m-okada/CPU298/README.md

# CPU298
CPU298 tiny 8 bit CPU.

フル機能版は https://github.com/m-okada/CPU2908
