m-okada/CPU298/CPU298.ods

Sheet: History
A00 | ”2021/04/18” | Create
B00 | “2022/09/28”

Sheet: Architecture
CPU298 アーキテクチャ
８ビットCPU、リトルエンディアン
レジスタ構成
データレジスタ | A
フラグ | FR | → | S | Z | C | フラグを内部バスに出力するルートは無いので、レジスタとして使用不可
インデックスレジスタ | X
 | Y |  | YはCALLの時にスタックとして使う
プログラムカウンタ | PC
アドレス計算にALUを使うようにして、回路規模を縮小。
相対ジャンプはフラグを変えるので、JA,JBE大事
アドレッシングモード
A
XH
XL
YH
YL
[X]
[Y]
zeropage

Sheet: Instruction
298 | Instruction Set |  |  |  |  |  |  |  |  |  |  |  |  |  |  | 2023/05/01
 | +00 | +01 | +02 | +03 | +04 | +05 | +06 | +07 | +08 | +09 | +0A | +0B | +0C | +0D | +0E | +0F
00 | NOP | MOV A,imm8 | MOV A,[imm16] | MOV A,[imm8] | MOV A,[X] | MOV A,[Y] | MOV A,[X+imm8] | MOV A,[Y+imm8] | MOV A,{imm8} | MOV {imm8},A | MOV [imm16],A | MOV [imm8],A | MOV [X],A | MOV [Y],A | MOV [X+imm8],A | MOV [Y+1mm8],A | 00
10 | MOV X,imm16 | MOV Y,imm16 | MOV X,[imm16] | MOV X,[imm8] | MOV X,[Y] | MOV Y,[imm16] | MOV Y,[imm8] | MOV Y,[X] | MOV A,{X+imm8} | MOV {X+imm8},A | MOV [imm16],imm16 | MOV [imm8],imm16 | MOV [X],imm16 | MOV [Y],imm16 | MOV [X+imm8],imm16 | MOV [Y+1mm8],imm16 | 10
20 | XCHG A,XL | XCHG A,XH | XCHG A,YL | XCHG A,YH | INC Y | ADD Y,2 | ADD Y,imm8 | MOV X,[Y+imm8] | XCHG XL,XH | XCHG YL,YH | XCHG X,Y | XCHG[imm8],A | DEC Y | SUB Y,2 | SUB Y,imm8 | MOV [Y+imm8],X | 20
30 | LEA |  |  |  | MOV X,[A] | MOV [A],X |  |  | MOV [X+],[Y+] | MOV [Y+],[X+] | MOV [X-],[Y-] | MOV [Y-],[X-] |  |  |  |  | 30
40 | PUSH [imm8] | PUSH [1mm16] | PUSH imm8 | PUSH imm16 | PUSH A | PUSH X | PUSH [A] | PUSH [X+A] | POP [imm8] | POP [imm16] |  |  | POP A | POP X | POP [A] | POP [X+A] | 40
50 |  |  |  |  |  |  |  |  | CLR A | CLR X | CLR Y | CLR [imm8] |  |  |  |  | 50
60 |  |  |  |  |  |  |  |  |  |  |  |  |  |  |  |  | 60
70 | SXT | NEG |  |  |  |  |  |  | SCR |  |  |  |  |  |  |  | 70
80 | ADD A,A | ADD A,imm8 | ADD A,[imm16] | ADD [imm8] | ADD A,[X] | ADD A,[Y] | ADD A,[X+imm8] | ADD A,[Y+1mm8] | SUB | A,imm8 | A,[imm16] | A,[imm8] | A,[X] | A,[Y] | A,[X+imm8] | A,[Y+imm8] | 80
90 | ADDC A,A | ADC A,imm8 | ADC A,[imm16] | ADC [imm8] | ADC A,[X] | ADC A,[Y] | ADC A,[X+imm8] | ADC A,[Y+1mm8] | SBB | A,imm8 | A,[imm16] | A,[imm8] | A,[X] | A,[Y] | A,[X+imm8] | A,[Y+imm8] | 90
A0 | AND | A,imm8 | A,[imm16] | A,[imm8] | A,[X] | A,[Y] | A,[X+imm8] | A,[Y+imm8] | CMP | A,imm8 | A,[imm16] | A,[imm8] | A,[X] | A,[Y] | A,[X+imm8] | A,[Y+imm8] | A0
B0 | XOR | A,imm8 | A,[imm16] | A,[imm8] | A,[X] | A,[Y] | A,[X+imm8] | A,[Y+imm8] | OR | A,imm8 | A,[imm16] | A,[imm8] | A,[X] | A,[Y] | A,[X+imm8] | A,[Y+imm8] | B0
C0 | NOT | X | [imm16] | [imm8] | [X] | [Y] | [X+imm8] | [Y+imm8] | TEST |  |  |  |  |  |  |  | C0
D0 | INC A | INC X | INC [imm16] | INC [imm8] | INC [X] | INC [Y] | INC [X+imm8] | INC [Y+imm8] | DEC A | X | [imm16] | [imm8] | [X] | [Y] | [X+imm8] | [Y+imm8] | D0
E0 | JNC(JAE) i8 | JC(JB) i8 | JNZ i8 | JZ i8 | JA i8 | JBE i8 | JNS i8 | JS i8 |  |  |  |  |  |  | JMPS i8 | JMPN imm8 | E0
F0 | BRK | TRAP |  |  |  | STC | CMC |  | CALL imm16 | CALL [imm8] |  | RET |  | JMP [X+A*2] | JMP imm16 | JMP [X] | F0
 |  | 動作未定義または実装未定
 |  | まだ実装してない |  | 黄色無印
 |  | 次ここ実装 |  | マゼンタ10
 |  | 回路動作確認町 |  | シアン10
 |  | 確認炭
 | Jcc i8はCP相対アドレス、8ビットイミディエート値オフセットは符号無し加算。
 | {}の指す16bit値でアドレッシングする
 | [imm8],[A] ゼロページ
 | +imm8 符号付き8ビットオフセット
 | SWB:Swap Byte.
 | SXT:Sign Extend.
 | PUSH/POP、CALL/RETのスタックはY
 | BRK 中身はNOPだけど、クロックを手動に切り替える
 | index mode
 | XCHG [Y+imm8],A | XCHG [Y+imm8],X | A,XL A,XH XL,XH X,Y

Sheet: μCode
15 | 14 | 13 | 12 | 11 | 10 | 9 | 8 | 7 | 6 | 5 | 4 | 3 | 2 | 1 | 0
Write | Read | /Thru | DEC/INC | ALU-Opecode |  |  |  | WriteBack-Selector |  |  | WR-Selector |  | ALU-A | ALU-B
Read=Write=1 |  | END_MARK 命令を終了してフェッチサイクルへ戻る
ALU-A |  | ALU A への入力、AかW
ALU-B |  | ALU B への入力、データバス、W、WR_H、WR_Lから選択
WR-Selector |  | ワードレジスタ出力選択
WriteBack-Selector |  | レジスタライトバック選択
DEC/INC |  | 1:DEC/0:INC
/Thru |  | 0:Thru Thru=0.DEC/INC=1 => add imm8(signed)
Write
Read
ALU Opecode |  | ALU-Opecode

Sheet: ALU_OP
CInv=A1&!A0&M#A2&!A1&A0&M ;
D3=!A1&!A0&M#!A2&A0&!M#A1&A0&M#A2&!A1&!M#A2&!A0&!M ;
D2=!A2&!A1&A0#!A1&A0&!M#!A2&A1&!M#A1&!A0&!M#A2&!A1&!A0&M ;
D1=!A2&A0#A0&M#A2&!A1&!A0&!M#A2&A1&M ;
D0=!A2&A1&!M#A2&!A1&A0&M#A2&A1&!A0&M ;
Mo=!A2&!A1#!A2&!A0&!M#!A1&!A0#A1&A0&M ;
Ci=A2&A1 ; | A1 & !A0 & M # A2 & A1
FL=!A1&!A0&!M#!A2&A1&A0&M#A2&!A1&!A0 ;
 |  | A3 | A2 | A1 | A0 | D3 | D2 | D1 | D0 | M | Ci | !FL | CInv
cupl truth table |  | A3 | A2 | A1 | A0 | D7 | D6 | D5 | D4 | D3 | D2 | D1 | D0
NOP |  | 0 | 0 | 0 | 0 | 0 | 0 | 0 | 0 | 1 | 0 | 1 | 0
AND |  | 0 | 0 | 0 | 1 | 1 | 0 | 0 | 0 | 1 | 0 | 0 | 0
OR |  | 0 | 0 | 1 | 0 | 1 | 1 | 1 | 0 | 1 | 0 | 0 | 0
XOR |  | 0 | 0 | 1 | 1 | 0 | 1 | 1 | 0 | 1 | 0 | 0 | 0
NOT |  | 0 | 1 | 0 | 0 | 0 | 1 | 0 | 1 | 1 | 0 | 0 | 0
INCA |  | 0 | 1 | 0 | 1 | 0 | 0 | 0 | 0 | 0 | 0 | 0 | 1 | Carryを立てて0を足すのでキャリーが反転するのに注意
DECA |  | 0 | 1 | 1 | 0 | 1 | 1 | 1 | 1 | 0 | 0 | 0 | 0
SignEx |  | 0 | 1 | 1 | 1 | 1 | 0 | 1 | 0 | 1 | 0 | 1 | 0
A-Thru |  | 1 | 0 | 0 | 0 | 1 | 0 | 1 | 0 | 1 | 0 | 1 | 0
B-Thru |  | 1 | 0 | 0 | 1 | 1 | 1 | 0 | 0 | 1 | 0 | 1 | 0
ADD |  | 1 | 0 | 1 | 0 | 1 | 1 | 0 | 0 | 0 | 0 | 0 | 0
SUB |  | 1 | 0 | 1 | 1 | 0 | 0 | 1 | 1 | 0 | 0 | 0 | 1
ADDC |  | 1 | 1 | 0 | 0 | 1 | 1 | 0 | 0 | 0 | 1 | 0 | 0
SUBB |  | 1 | 1 | 0 | 1 | 0 | 0 | 1 | 1 | 0 | 1 | 0 | 1
ADC0 |  | 1 | 1 | 1 | 0 | 0 | 0 | 0 | 0 | 0 | 1 | 0 | 0
SHR |  | 1 | 1 | 1 | 1 | 1 | 0 | 1 | 0 | 1 | 1 | 0 | 0
Cin 0の時0、1の時Carry
CInv(キャリー反転)はcarry入力、出力とも反転する
Carry出力はMが0の時Carry 1でExOpe&SHRの時に入力Bit0
M 0:Adder 1:LOP
A2..A0,M 4bitのOpe選択
 |  |  |  |  |  |  |  |  |  |  |  |  |  |  | addr
 |  |  |  |  |  |  |  |  |  |  |  |  |  |  | DEC/INC | ADD/THRU | Carry | Cout
 |  |  |  |  |  |  |  |  |  |  |  |  |  |  | 0 | 0 | 0 | 0 | Thru
 |  |  |  |  |  |  |  |  |  |  |  |  |  |  | 0 | 0 | 1 | X | X
 |  |  |  |  |  |  |  |  |  |  |  |  |  |  | 0 | 1 | 0 | 0 | INC
 |  |  |  |  |  |  |  |  |  |  |  |  |  |  | 0 | 1 | 1 | 1
 |  |  |  |  |  |  |  |  |  |  |  |  |  |  | 1 | 0 | 0 | 0 | ADD
 |  |  |  |  |  |  |  |  |  |  |  |  |  |  | 1 | 0 | 1 | 1
 |  |  |  |  |  |  |  |  |  |  |  |  |  |  | 1 | 1 | 0 | 1 | DEC
 |  |  |  |  |  |  |  |  |  |  |  |  |  |  | 1 | 1 | 1 | 0
 |  |  |  |  |  |  |  |  |  |  |  |  |  |  | DEC/INC | ADD/THRU | CarryIn
 |  |  |  |  |  |  |  |  |  |  |  |  |  |  | 0 | 0 | 0
 |  |  |  |  |  |  |  |  |  |  |  |  |  |  | 0 | 1 | 1
 |  |  |  |  |  |  |  |  |  |  |  |  |  |  | 1 | 0 | 0
 |  |  |  |  |  |  |  |  |  |  |  |  |  |  | 1 | 1 | 0

Sheet: PIN
 |  |  |  | CPU298 40PIN
 | I/O |  |  |  |  |  | I/O
クロック | I | CLK | 1 |  | 40 | Vcc | +5V | 電源
バス使用予告 | O | AVMA | 2 | CPU298 | 39 | Q | O
 |  |  | 3 |  | 38 | C | O
 |  |  | 4 |  | 37 | E | O
 |  |  | 5 |  | 36 | STATE | O | ステートアップデート
 |  |  | 6 |  | 35 | S1 | O | プロセッサステート | 0:フェッチ 1::実行
リセット | I | Reset | 7 |  | 34 | RD | O | 読み出し
アドレス | O | A0 | 8 |  | 33 | WR | O | 書き込み
 | O | A1 | 9 |  | 32 | D0 | I/O | データ
 | O | A2 | 10 |  | 31 | D1 | I/O
 | O | A3 | 11 |  | 30 | D2 | I/O
 | O | A4 | 12 |  | 29 | D3 | I/O
 | O | A5 | 13 |  | 28 | D4 | I/O
 | O | A6 | 14 |  | 27 | D5 | I/O
 | O | A7 | 15 |  | 26 | D6 | I/O
 | O | A8 | 16 |  | 25 | D7 | I/O
 | O | A9 | 17 |  | 24 | A15 | O | アドレス
 | O | A10 | 18 |  | 23 | A14 | O
 | O | A11 | 19 |  | 22 | A13 | O
電源 | GND | Vss | 20 |  | 21 | A12 | O

Sheet: TimingChart
 |  |  |  | ← |  | CPUサイクル |  | → | ← | CPUサイクル | → | →
 |  |  |  | 50ns＠20MHz
Reset | Clock |  | Q
 |  |  | C
 |  |  | E
fetch/execute | Clock |  | Q
 |  |  | C
 |  |  | E
Read cycle | ExternBusCtrl | Buffer | Addr/Data Latch |  | ←
 |  | Strobe | Read(OE)
Write cycle | ExternBusCtrl | Buffer | Addr/Data Latch |  | ←
 |  |  | Data Out Enable
 |  | Strobe | Write(WE)
Sequencer | Instruction |  | Instruction Register |  |  |  | ←
 | ControlCode
 |  |  | Fetch | ←
 |  | State | State-update |  |  | ←
 |  |  | ENDF | ←
 |  | uROM | uROM-addr-load |  | ←
 |  |  | uROM-addr-update |  |  | ←
Executer |  | Register | WriteBack |  |  |  | ←
 |  |  | WitebackDecoder OE |  |  |  | ←
 |  | Flag | Fetch |  |  |  |  | ←
Execute | Clock |  | Q
 |  |  | C
 |  |  | E

Sheet: Parts List
Block | Part no |  | 用途 | 備考
ExBus
 | 74HC74 | D-FFx2 | IRQA、DataOutコントロール
 | 74HC74 |  | RD、WRコントロール
 | 74HC08 | 2ANDx4
 | 74HC08
 | 74HC04 | INVx6
 | 74HC574 | D-FFx8 | Addr-Hi Latch
 | 74HC574 |  | Addr-Lo Latch
 | 74HC574 |  | DataOut Latch
 | 74HC125 | 3-State Buffer | Ctrl signal
Sequencer
 | 74HC74 |  | Stage Ctrl, Step Ctr.
 | 74HC74 |  | State Ctrl
 |  |  | Opecode Register
 | 74HC157 | 2to1x4 | JMPcc,OpeCodeSelector
 | 74HC157 |  | State Index Selector
 | 74HC157
 | 74HC08
 | 74HC08 |  |  | Jccに2回路
 | 74HC11 | 3ANDx3
 | 74HC32 | 2ORx4
 | 74HC04
 | 74HC21 | 4ANDx2 | INTイネーブル、Eライン | 1個余るのでStateCtrlとJccは一緒
 | 74HCT273 |  | μROM OUT
 | 74HCT273
 | 74HCT273
 | 74HCT273
 | 74HC541 |  | Datain imm8 selector
 | 74HCT574 |  | DataIn buffer
 | 74HC541 |  | DataIn thru
 | 74HC377 |  | μROM アドレスバッファ
 | 74HC161 |  | カウンタ
 | 74HC161
Jcc | 74HC161
 | 74HC11 | 3ANDx3
 | 74HC153 | 4to1x2 | Jcc フラグセレクタ | 1回路余り
 | 74HC04
 | 74HC86 | 2XORx4 |  | 一回路余り
 | 74HC32
Executer
 | 74HC574 |  | R0 | レジスタにLEDつけるのでピンの並びで574
 | 74HC574 |  | R1
 | 74HC574 |  | R2
 | 74HC574 |  | R3
 | 74HC377 |  | Buff1
 | 74HC377 |  | Buff2
 | 74HC574 |  | A0
 | 74HC574
 | 74HC574 |  | A1
 | 74HC574
 | 74HC574 |  | CP
 | 74HC574
 | 74HC574 |  | SP
 | 74HC574
 | 74HC238 |  | WriteBack
 | 74HC139 |  | BRSelector,BuffSel
 | 74HC541 | 3stateBuffer | BR out sel | ByteRegは別回路にするので、出力ディセーブル用
 | 74HC541 |  | DataIn
 | 74HC541 |  | BUSReturn
 | 74HC541 |  | AddrHI
 | 74HC541 |  | AddrLo
 | 74HC541 |  | addrLoOut
 | 74HC541 |  | addrHiOut
 | 74HC153 |  | WR out sel
 | 74HC153
 | 74HC153
 | 74HC153
 | 74HC153
 | 74HC153
 | 74HC153
 | 74HC153
Flag
 | 74HC377
 | 74HC157
 | 74HC157
CarrySelector
 | 74HC153
ALU
 | 74HC283 | 4bit adder
 | 74HC283
 | 74HC153 | Logic unit
 | 74HC153
 | 74HC153
 | 74HC153
 | 74HC153 | Out selector
 | 74HC153
 | 74HC153
 | 74HC153
 | 74HC86
 | 74HC153 |  | CarryOut
 | 74HC08
 | 74HC32
 | 74HC04
 | 74HC4078 | 8NOR | Zeroflag
AddrEx
 | 74HC08 | 2ANDx4 | Reg to 0
 | 74HC08
 | 74HC08
 | 74HC08
 | 74HC08 |  | selector
 | 74HC32 | 2ORx4
 | 74HC04 | NOTx6
 | 74HC157 | 2to1x4 | buff selector
 | 74HC157
 | 74HC157
 | 74HC157
 | 74HC283 |  | adder
 | 74HC283
 | 74HC283
 | 74HC283
 | Part no | 数 |  | 型番 | パッケージ | サプライヤー | ベンダー | PDF
 | 74HC04 | 5 |  | TC74VHCT04AFT | TSSOP14-P-0.65A | Toshiba | 秋月電子通商 | http://akizukidenshi.com/download/ds/toshiba/TC74VHCT04AFT.pdf
 | 74HC08 | 10 |  | 74HC08D,652 | SO14 | Nexperia | Digikey | https://assets.nexperia.com/documents/data-sheet/74HC_HCT08.pdf
 | 74HC11 | 2 |  | SN74HC11D | SO14 | TI | Digikey | http://www.ti.com/lit/ds/symlink/sn74hc11.pdf
 | 74HC138 | 0 |  | MC74HC138ADG | SOIC-16 | ON Semi | Digikey | https://www.onsemi.com/pub/Collateral/MC74HC138A-D.PDF
 | 74HC153 | 4 |  | 74HC153D,652 | SOIC-16-3.8mm | ON Semi | RSコンポーネンツ | https://docs-apac.rs-online.com/webdocs/1210/0900766b812104c5.pdf
 | 74HC157 | 9 |  | SN74HC157 | SOIC-16-3.8mm | TI | Digikey | http://www.ti.com/lit/ds/symlink/sn74hc157.pdf
 | 74HC21 | 1 |  | SN74HC21D | SOIC-14-3.8mm | TI | Digikey | http://www.ti.com/lit/ds/symlink/sn74hc21.pdf
 | 74HC238 | 1 | WriteBack active-hi | TC74HC238D | SOIC-16-1.27-3.8mm | Toshiba | Digikey | 74HC238D_datasheet_en_20160804.pdf
 | 74HC283 | 6 |  | CD74HC283M96 | SOIC-16-1.27-3.9mm | TI | Digikey | http://www.ti.com/lit/ds/symlink/cd74hc283.pdf
 | 74HC32 | 4 |  | 74AHC32D,118 | SOIC-14-3.9mm | Nexperia | Digikey | https://assets.nexperia.com/documents/data-sheet/74AHC_AHCT32.pdf
 | 74HC377 | 4 |  | SN74HC377NSR | SOIC-20-5.3 | Nexperia | chip1stop | http://www.ti.com/lit/ds/symlink/sn74hc377.pdf
 | 74HC4078 | 1 |  | TC74HC4078AF | SOP14-1.27-5.3m | Toshiba | chip1stop | https://www.marutsu.co.jp/contents/shop/marutsu/datasheet/TC74HC4078A.pdf
 | 74HC541 | 9 |  | TC74VHCT541AFT | TSSOP-20-0.65-4.4mm | Toshiba | 秋月電子通商 | http://akizukidenshi.com/download/ds/toshiba/TC74VHCT540_541AF.pdf
 | 74HC574 | 10 | LEDつけるのでSOIC | TC74VHC574F | SOP20-P-300-1.27A | Toshiba | 秋月電子通商 | TC74VHC574F_datasheet_ja_20190131.pdf
 | 74HC74 | 4 |  | MC74HC74ADG | SIOC-14-3.8mm | ON Semi | Digikey | https://www.onsemi.jp/PowerSolutions/document/MC74HC74A-D.PDF
 | 74HC86 | 2 |  | SN74AHC86D | SOIC-14-3.9mm | TI | Digikey | http://www.ti.com/lit/ds/symlink/sn74ahc86.pdf
 | 74HCT574 | 1 |  | SN74HCT574 | SOIC-20-5.3mm | TI | Digikey | http://www.ti.com/lit/ds/symlink/sn74hct574.pdf
 | 74HCT273 | 2 | μROMラッチ TTLを受けるのでHCT、あとリセット付き | 74HCT273D,653 | SO20-1.27.7.5mm | Nexperia | chip1stop | https://assets.nexperia.com/documents/data-sheet/74HC_HCT273.pdf
 | 74HC125 | 1 |  | TC74HC125 | SOP14-1.27-5.3mm | Toshiba | 手持ち | https://www.marutsu.co.jp/contents/shop/marutsu/datasheet/TC74HC125A.pdf
 | 74HCT125 | 0 |  | MC74ACT125 | SOIC-14 |  | 手持ち | https://www.onsemi.jp/PowerSolutions/document/MC74AC125-D.PDF
 | 74HC161 | 3 |  | TC74HC161AF | SOP-16-5.3mm | Toshiba | 秋月電子通商 | http://akizukidenshi.com/download/ds/toshiba/TC74HC161A.pdf
 | 74HC139 | 1 |  | MC74HC139ADR2G | SOIC-16-1.27-3.8mm | ON Semi | Digikey | https://www.onsemi.com/pub/Collateral/MC74HC139A-D.PDF
 | N61C64 | 0 | SRAM | N61C64AL-10JLI | SOJ-28 |  |  | http://www.issi.com/WW/pdf/61C64AL.pdf
 | 74HCT541 | 0
 | 74HC153 | 4
 |  | 0
 | 74ACT125 | 0 |  | MC74ACT125 | SIOC-14-3.8mm | ON Semi | 手持ち | https://www.onsemi.com/pub/Collateral/MC74AC125-D.PDF
 | TC7S32F | 0 |  | TC7S32F | SSOP-5 | Toshiba | 秋月電子通商 | http://akizukidenshi.com/download/ds/Toshiba/TC7S32F_datasheet_ja_20140301.pdf
 |  | 84
 | コントローラ
 | SRAM | 4 |  | IS61C64AL-10JLI-TR | 28-SOJ | ISSI | MOUSER | 8kx8 10ns
 | LED-Green
 | LED-White
 | 10K
 | 47K
 | 0.1uF

Sheet: PartsList2
パーツリスト
 |  |  | # | 概要 | Function | 型番 | ピン数 | 数 | 機能
Core | Extern Bus | Addr Buffer |  | HC574 |  | TC74HC574 | 20 | 2 | 100個ならDigiKeyが安い
 |  | Data Out Buffer |  | HC574 |  |  | 20 | 1
 |  | Data In Buffer |  | HCT541 |  |  | 20 | 1
 | clock |  |  | HC175 | 4xDFF |  | 16 | 1 | リセット時のメタステーブル対策
 |  |  |  | HC175 | 4xDFF |  | 16 | 1 | クロック生成
 |  |  |  | HC04 | NOT |  | 14 | 1 | 4回路余り
 | Bus ctrl |  |  | HC00 | 2NAND |  |  | 1
 |  |  |  | HC02 | 2NOR |  |  | 1
 |  |  |  | HC04 | NOT |  |  | 0 | clockからもらう
 | manual clock |  |  | HC00 | 2NAND |  | 14 | 1 | SRラッチ、チャタリング除去
Sequencer |  | μROM |  | 27C1024 | x16-μROM |  | 44 | 0 | PLCC-45NS OTP
 |  |  |  | AT28HC64B | 8Kx8-μROM |  | 32 | 1 | PLCC-70JU
 |  |  |  | HC574 | μROM-Lo Latch |  |  | 1
 |  |  |  | HC377 | Instruction Register |  | 20 | 1
 |  |  |  | HC377 | μROM addr Hi |  | 20 | 1
 |  |  |  | HC161 | μROM addr Lo |  | 16 | 1 | 4bit counter
 |  |  |  | HC74 | State control |  |  | 1 |  | 共立
 |  |  |  | HCT74 | Step bit0 |  | 14 | 1
 |  | CtrlCode |  | HCT273 |  |  | 20 | 2
 |  | Jcc |  | HC157 |  |  | 16 | 1
 |  | misc |  | HC11 | 3AND |  |  | 1 | 1回路はOpGenへ
 |  |  |  | HC08 | 2AND |  |  | 1
 |  |  |  | HC86 | 2XOR |  |  | 1 | 3回路あまり ALUへ
 |  |  |  | HC02 | 2NOR |  |  | 1 | 1回路あまり
 |  |  |  | HC153 | 4to1 Mutex |  | 16 | 1
 |  |  |  | HC157 | 2to1 Mutex |  | 16 | 2
 |  |  |  | HC04 | NOT |  |  | 2
Executer |  | Register |  | HC377,HC273 |  |  |  | 2 | A,W
 |  |  |  | HC574 |  |  |  | 8 | WORD Register
 |  | RegisterSelector |  | 74HC153 | 4to1x2 |  |  | 4 | ALU_A Selector | 樫木総業
 |  |  |  | HC541 |  |  |  | 0
 |  |  |  | HC157 | 2to1 |  |  | 2 | ALU_B Selector
 | Addr inc/dec | INC/DEC8 |  | GAL22 | 8bit INC/DEC |  | 24 | 1
 |  |  |  | GAL16 | Carry Gen |  | 20 | 1
 |  |  |  | HC283 | 4Adder |  | 16 | 2
 | ALU | OPGen |  | GAL16 |  |  | 20 | 1
 |  |  |  | HC21 | 4AND |  | 14 | 1
 |  |  |  | HC04 | NOT |  |  | 1
 |  | ALU_L |  | GAL16 | 4to1x4 |  |  | 2
 |  | ALU_A |  | HC283 |  |  |  | 2
 |  |  |  | HC541 | 3State8 |  |  | 1
 |  | Ext |  | GAL22 |  |  | 24 | 1
 |  | Flag |  | HC74 |  |  |  | 2
 |  |  |  |  |  |  |  | 60
SubBoard
