m-okada/CPU298/(list of files, drawings)

Other design files:
CPU298.circ
CPU298_parts_placement.circ
