m-okada/CPU298/(commit log)

2021-06-01 Add CPU298.ods
    [CPU298.circ, CPU298.ods]
2021-06-03 add makefile.
    [CPU298.circ, CPU298.ods, urom_A00.obj]
2021-06-04 Modify circ
    [CPU298.circ, CPU298.ods]
2021-06-04 Add ALU_OP_ROM*.*
    [CPU298.circ, CPU298.ods]
2021-06-05 Add INC_DEC_8.PLD
    [CPU298.circ]
2021-06-05 SignEx move into ALUblock.
    [CPU298.circ]
2021-06-06 Update uROM.
    [CPU298.circ, CPU298.ods, urom_A00.obj]
2021-06-09 ADD ALU_ROM.
    [CPU298.circ, CPU298.ods, urom_A00.obj]
2021-06-09 Update ROM
    [urom_A00.obj]
2021-06-09 remove exe,obj
    [urom_A00.obj]
2021-06-10 Update uROM
    [CPU298.circ]
2021-06-10 Update ALU_ROM
    [CPU298.circ]
2021-06-12 Move ALU_OP to 1 bit right.
    [CPU298.circ, CPU298.ods]
2021-06-13 Fix minor bug.
    [CPU298.circ]
2021-06-13 Support sign flag
    [CPU298.circ]
2021-06-13 Support JA JBE
    [CPU298.circ]
2021-06-13 Support ST [X],A
    [CPU298.circ, CPU298.ods]
2021-06-17 Create KiCAD project.
    [CPU298.circ, CPU298.kicad_pcb, CPU298.ods, CPU298.sch]
2021-06-19 Add some opecode.
    [CPU298.circ, CPU298.ods, CPU298.sch]
2021-06-23 Updater circuit.
    [CPU298.circ, CPU298.ods]
2021-06-23 Add INC/DEC to ALU-OP.
    [CPU298.circ, CPU298.ods]
2021-06-25 Clean up circuit.
    [CPU298.circ, CPU298.ods]
2021-06-25 Implement 0x0e LD A.[X+imm8]
    [CPU298.circ]
2021-06-27 Modify some OpeCode
    [CPU298.circ, CPU298.ods]
2021-06-27 Support break ope
    [CPU298.circ, CPU298.ods]
2021-06-29 Modify Circuit
    [CPU298.circ, CPU298.ods]
2021-06-29 uROM bug fix
    [CPU298.circ, CPU298.ods]
2021-07-07 Remove some gates.
    [CPU298.ods, CPU298_parts.circ]
2022-02-25 Support ROR instruction.
    [CPU298.ods, CPU298_parts.circ]
2022-03-31 Add Jcc.PLD
    [CPU298.ods, CPU298_parts.circ]
2022-09-15 ちょっといじった
    [CPU298.ods, CPU298_parts.circ]
2023-03-21 Add HQ clock edge
    [CPU298A_parts.circ, CPU298B.ods, CPU298B_parts.circ]
2023-03-31 debug シーケンサの
    [CPU298B.ods, CPU298_B2.circ, CPU298_B2_parts.circ]
2023-05-05 Fix adder bug.
    [7400-lib-td4.circ, 7400-lib.circ, ALU.circ, CPU298.ods, CPU298B.ods, CPU298_B2.circ, CPU298_B3.circ, CPU298_C1.circ]
2023-05-09 Clean cache.
    [CPU298.circ, CPU298.ods, CPU298.sch]
2023-05-14 Update fetch timing.
    [CPU298.circ, CPU298.ods]
2023-05-17 Update some logic.
    [CPU298.circ, CPU298.ods]
2023-05-19 Fix flag fetch timing.
    [CPU298.circ, CPU298.ods]
2023-05-20 Fix carry flag bug on ShiftRightWithCarry instruction.
    [CPU298.circ, CPU298.ods]
2023-05-23 Change some devices.
    [CPU298.circ, CPU298.ods]
2023-05-23 Fix header file write bug.
    [CPU298.circ, CPU298.ods]
2023-05-26 Clean up.
    [7400-lib-td4.circ, 7400-lib.circ, CPU298.circ, CPU298.ods, CPU298A_parts.circ, CPU298B.ods, CPU298B_parts.circ, CPU298_B2.circ]
2023-05-27 Remove 1 D-FF
    [ALU.circ, CPU298.circ, CPU298.ods]
2023-05-28 Ssimplify sequencer.
    [CPU298.circ, CPU298.ods]
2023-05-28 Fix /OE /WR Control logic.
    [CPU298.circ, CPU298.ods]
2023-05-30 8bit offset adder.
    [CPU298.circ, CPU298.ods, CPU298.sch, Executer.sch, sequencer.sch]
2023-05-30 Bug fix.
    [CPU298.circ, CPU298.ods]
2023-06-01 Simply Circuit.
    [CPU298.circ, CPU298.ods]
2023-06-04 Support 8Kx8bit EPROM for uROM.
    [CPU298.circ, CPU298.ods, CPU298_parts_placement.circ]
2023-06-07 Create AtmelStudio solution.
    [CPU298.circ, CPU298.ods]
2023-07-25 Support Int trap
    [CPU298.circ, CPU298.ods, CPU298.sch]
